jvillemejane/as-spectrum/demo/2024_05_02_Bug_bandeau_led.jpg

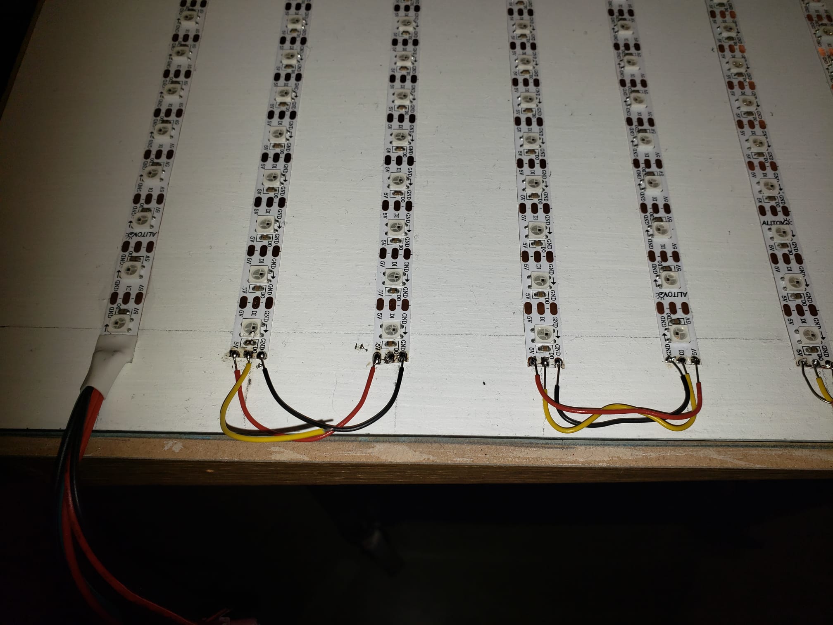
demo/2024_05_02_Bug_bandeau_led.jpg
