jvillemejane/as-spectrum/README.md

# Arts et Sciences Project
2023-2024

This is a test.
