jvillemejane/as-spectrum/Poster_Light_Analyzer.pptx

2023-2024

| INGRID BEVILLARD
| CHRISTOF DIJKSTRA
| MAXENCE DROUIN
| ORIANE KOELLSCH
| APOLLINE GUTH
| MARIE-CAPUCINE POMEAU

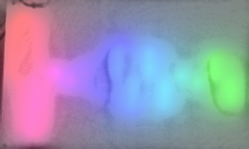
[picture p2: figure]

SPECTRUM

Réalisation d’une œuvre interactive

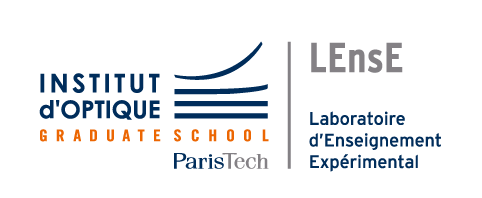
[picture p3: figure]

https://lense.institutoptique.fr/

du son . . .

Onde acoustique

Somme
de notes

Micro

Passe-Bande 1

Passe-Bande 2

Passe-Bande 7

…

Quantification

Traitement
Numérique

Détection niveau

Bande 1

Bande 2

Niveau élevé

Niveau faible

Bande 7

Affichage

Réglage
Intensité

1 note =
1 fréquence

Réglage
Volume

Découpage fréquentiel

Rayonnement électromagnétique

. . . à la lumière

de l’idée . . .

Tableau

Quand l’ingénierie rencontre l’art

Interaction

Son

Lumière

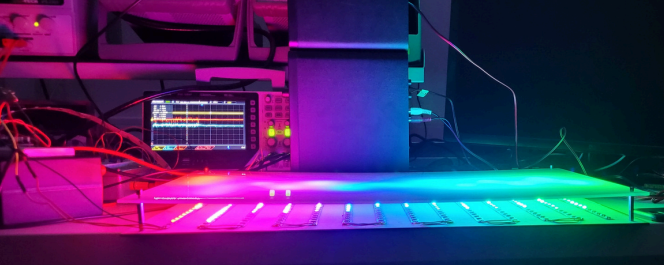
[picture p4: figure]
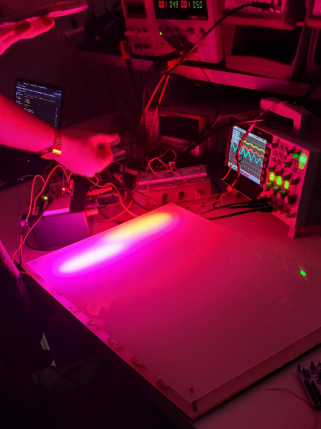
[picture p5: figure]
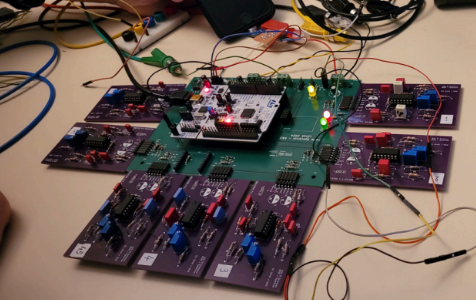
[picture p6: figure]

1 carte mère

3 modes

Analyzer interaction avec le son

Screensaver

Démo

Travail collaboratif

6 étudiant.es

1 artiste

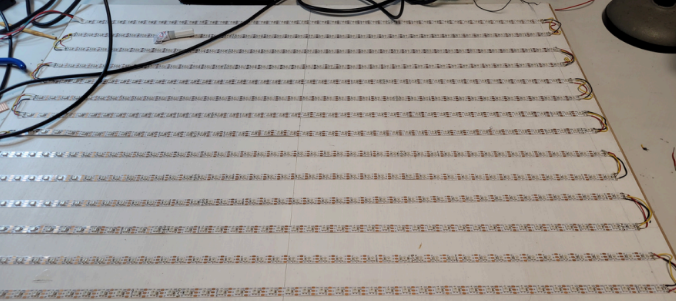
[picture p7: figure]

7 filtres

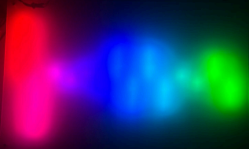
[picture p8: figure]

. . . au prototype

| ERIC MICHEL / Artiste Lumière
| JULIEN VILLEMEJANE

1 laboratoire expérimental

1 ingénieur

630 LEDs

Arts et Sciences

http://artsetsciences.institutoptique.fr/

Un projet

Encadré par
