jvillemejane/as-spectrum/elec_boards/BUG_A_CORRIGER.txt

AS-Spectrum / 'Arts et Sciences' Project / 2024
===============================================

Bugs on electronic board
************************

Bugs on embedde program
***********************
- InterruptIn on PB_12 and PA_12 impossible together ! Delete misc input :/ or no interrupt.
