jvillemejane/as-spectrum/Poster_Light_Analyzer.pdf

du son . . .

## Réalisation d’une œuvre interactive

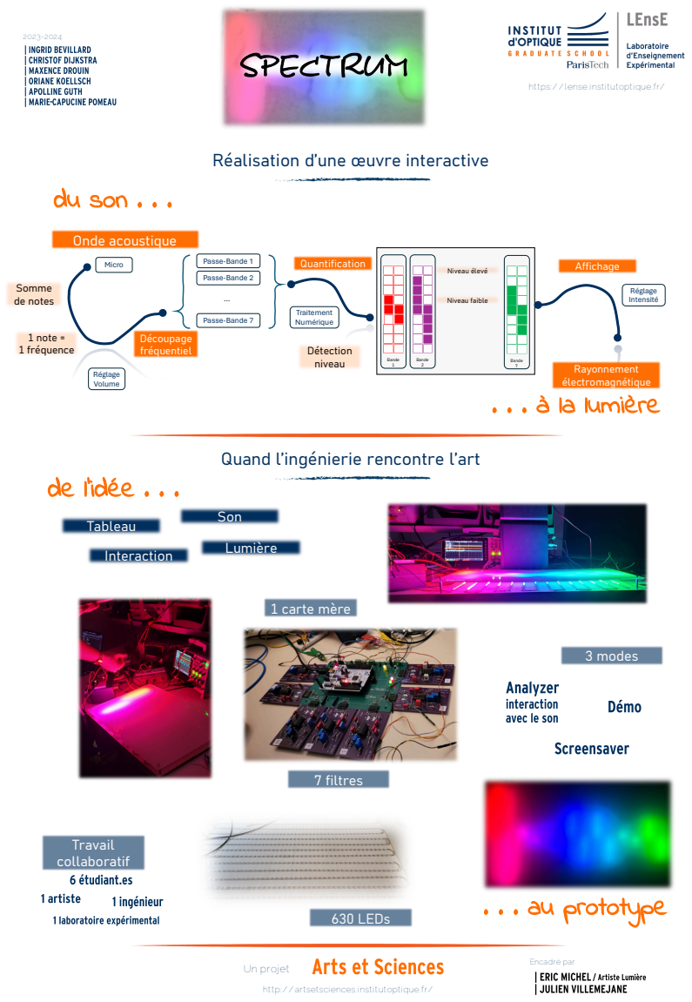
[picture p27: page 1]
Un projet; de l’idée . . .; . . . au prototype; Encadré par; Onde acoustique; Somme de notes; Bande 1; Bande 2; Passe-Bande 1; Passe-Bande 2; Passe-Bande 7; Micro; 1 note = 1 fréquence; Découpage fréquentiel; Quantification; Détection niveau; Traitement Numérique; Niveau faible; Bande 7; Niveau élevé; Affichage; Réglage Volume; Réglage Intensité; Rayonnement électromagnétique . . . à la lumière; SPECTRUM; Tableau; Interaction; Son; Lumière; 630 LEDs; 7 filtres; 3 modes; Travail collaboratif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

https://lense.institutoptique.fr/

Quand l’ingénierie rencontre l’art

http://artsetsciences.institutoptique.fr/
