jvillemejane/as-spectrum/elec_boards/main_board/spectrum_main_pcb.pdf

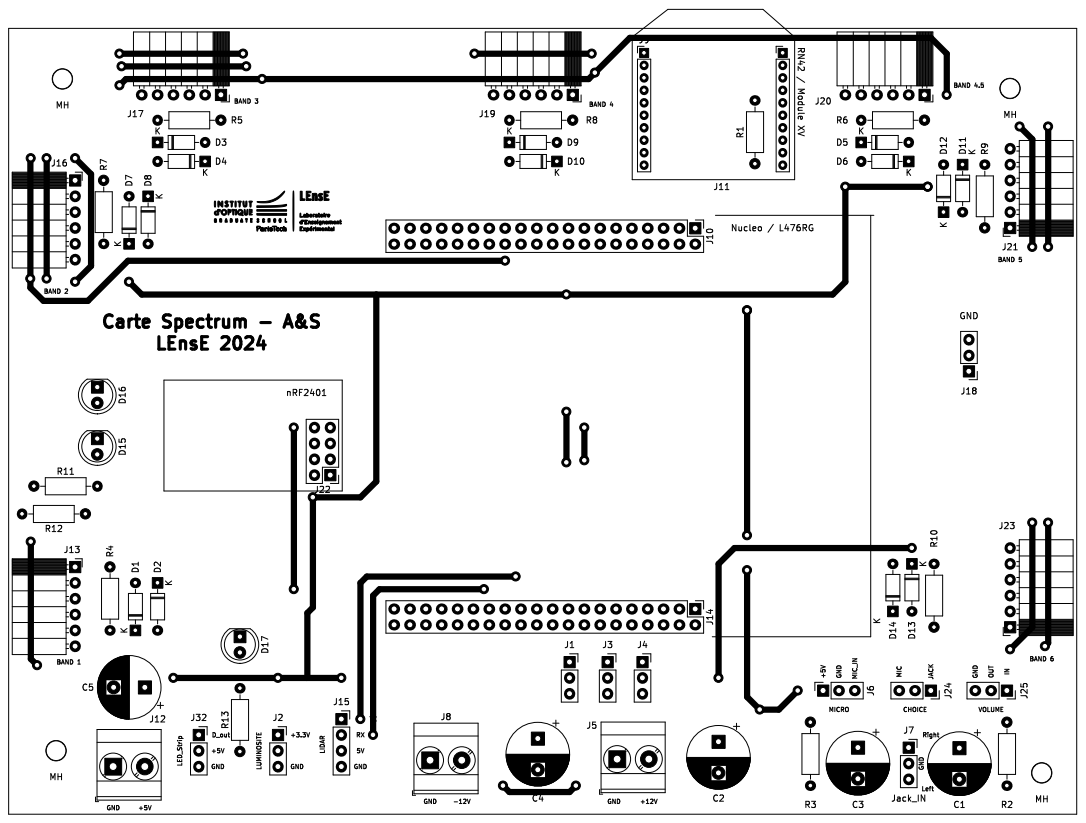
[picture p28: page 1]
