jvillemejane/as-spectrum/elec_boards/main_board/spectrum_main_schematic.pdf

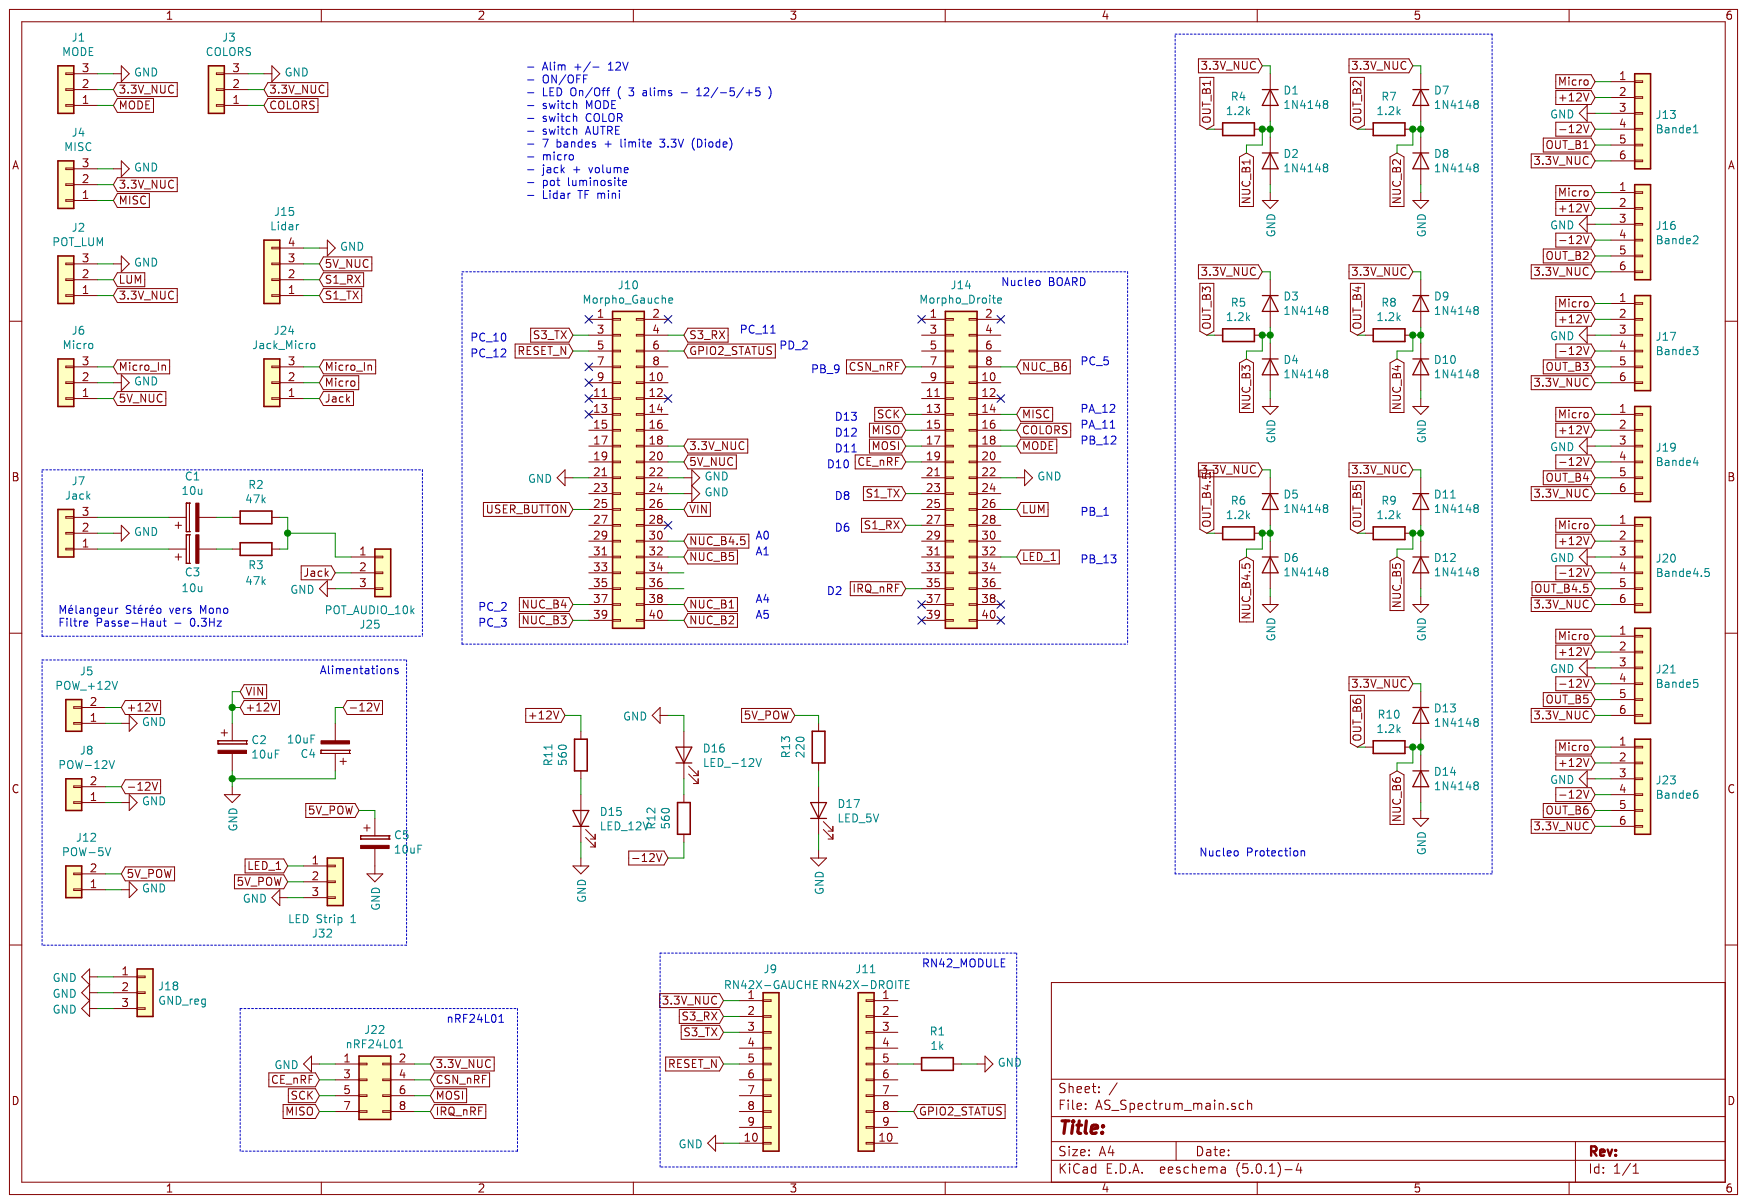
[picture p29: page 1]
