jvillemejane/as-spectrum/elec_boards/filters/spectrum_filter_pcb.pdf

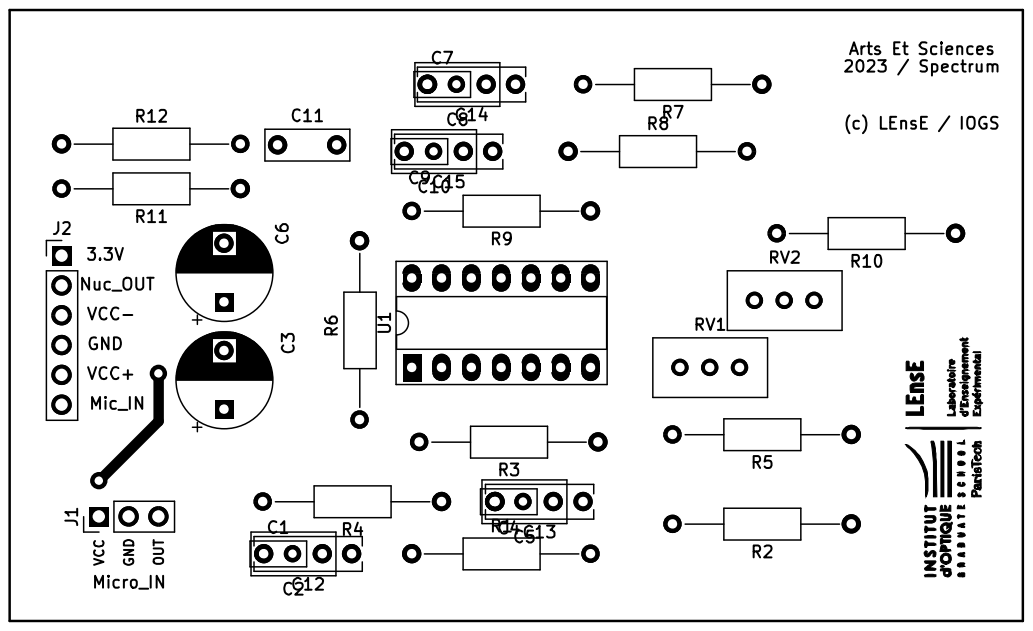
[picture p30: page 1]
