jvillemejane/as-spectrum/elec_boards/filters/spectrum_filter_schematic.pdf

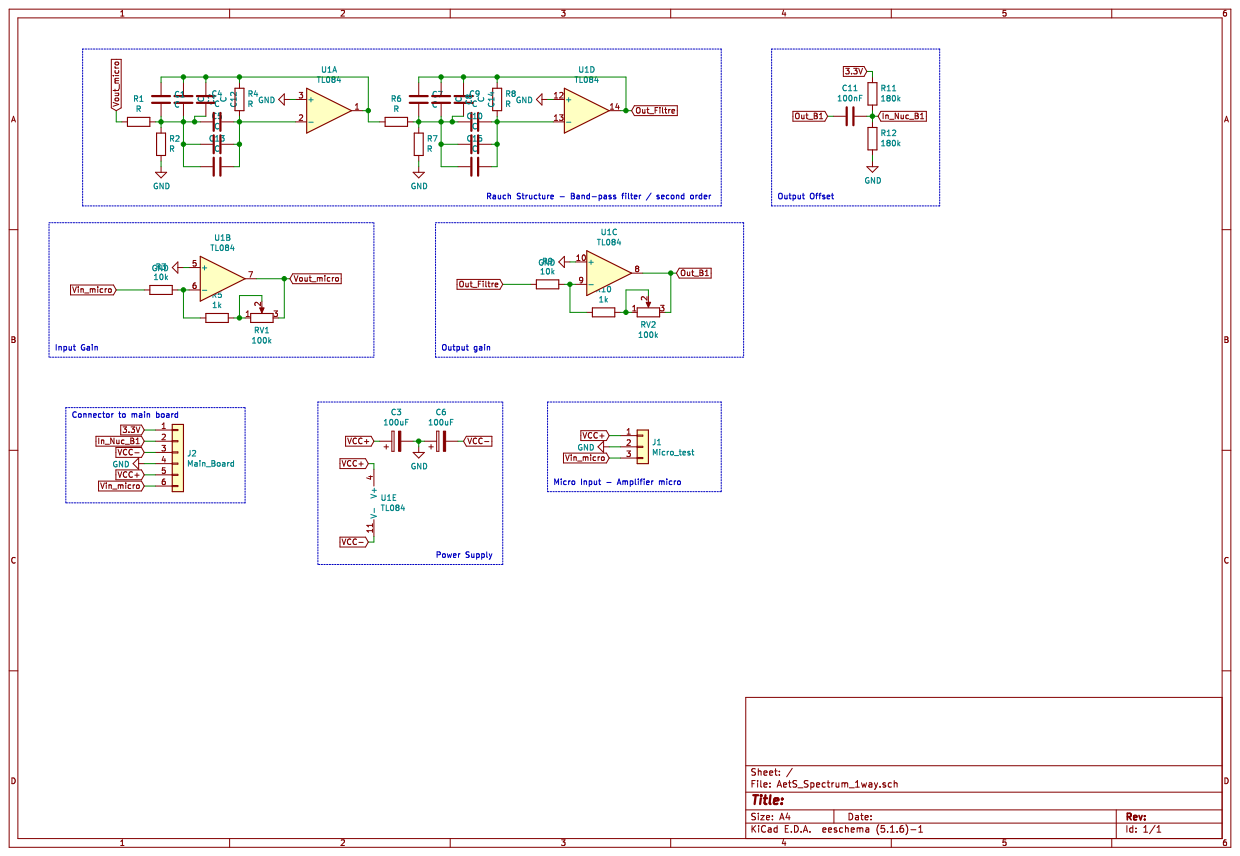
[picture p31: page 1]
