jvillemejane/as-spectrum/elec_boards/main_board/AS_Spectrum_main.kicad_pcb

## KiCad design elec_boards/main_board/AS_Spectrum_main.kicad_pcb (2024-02-15)

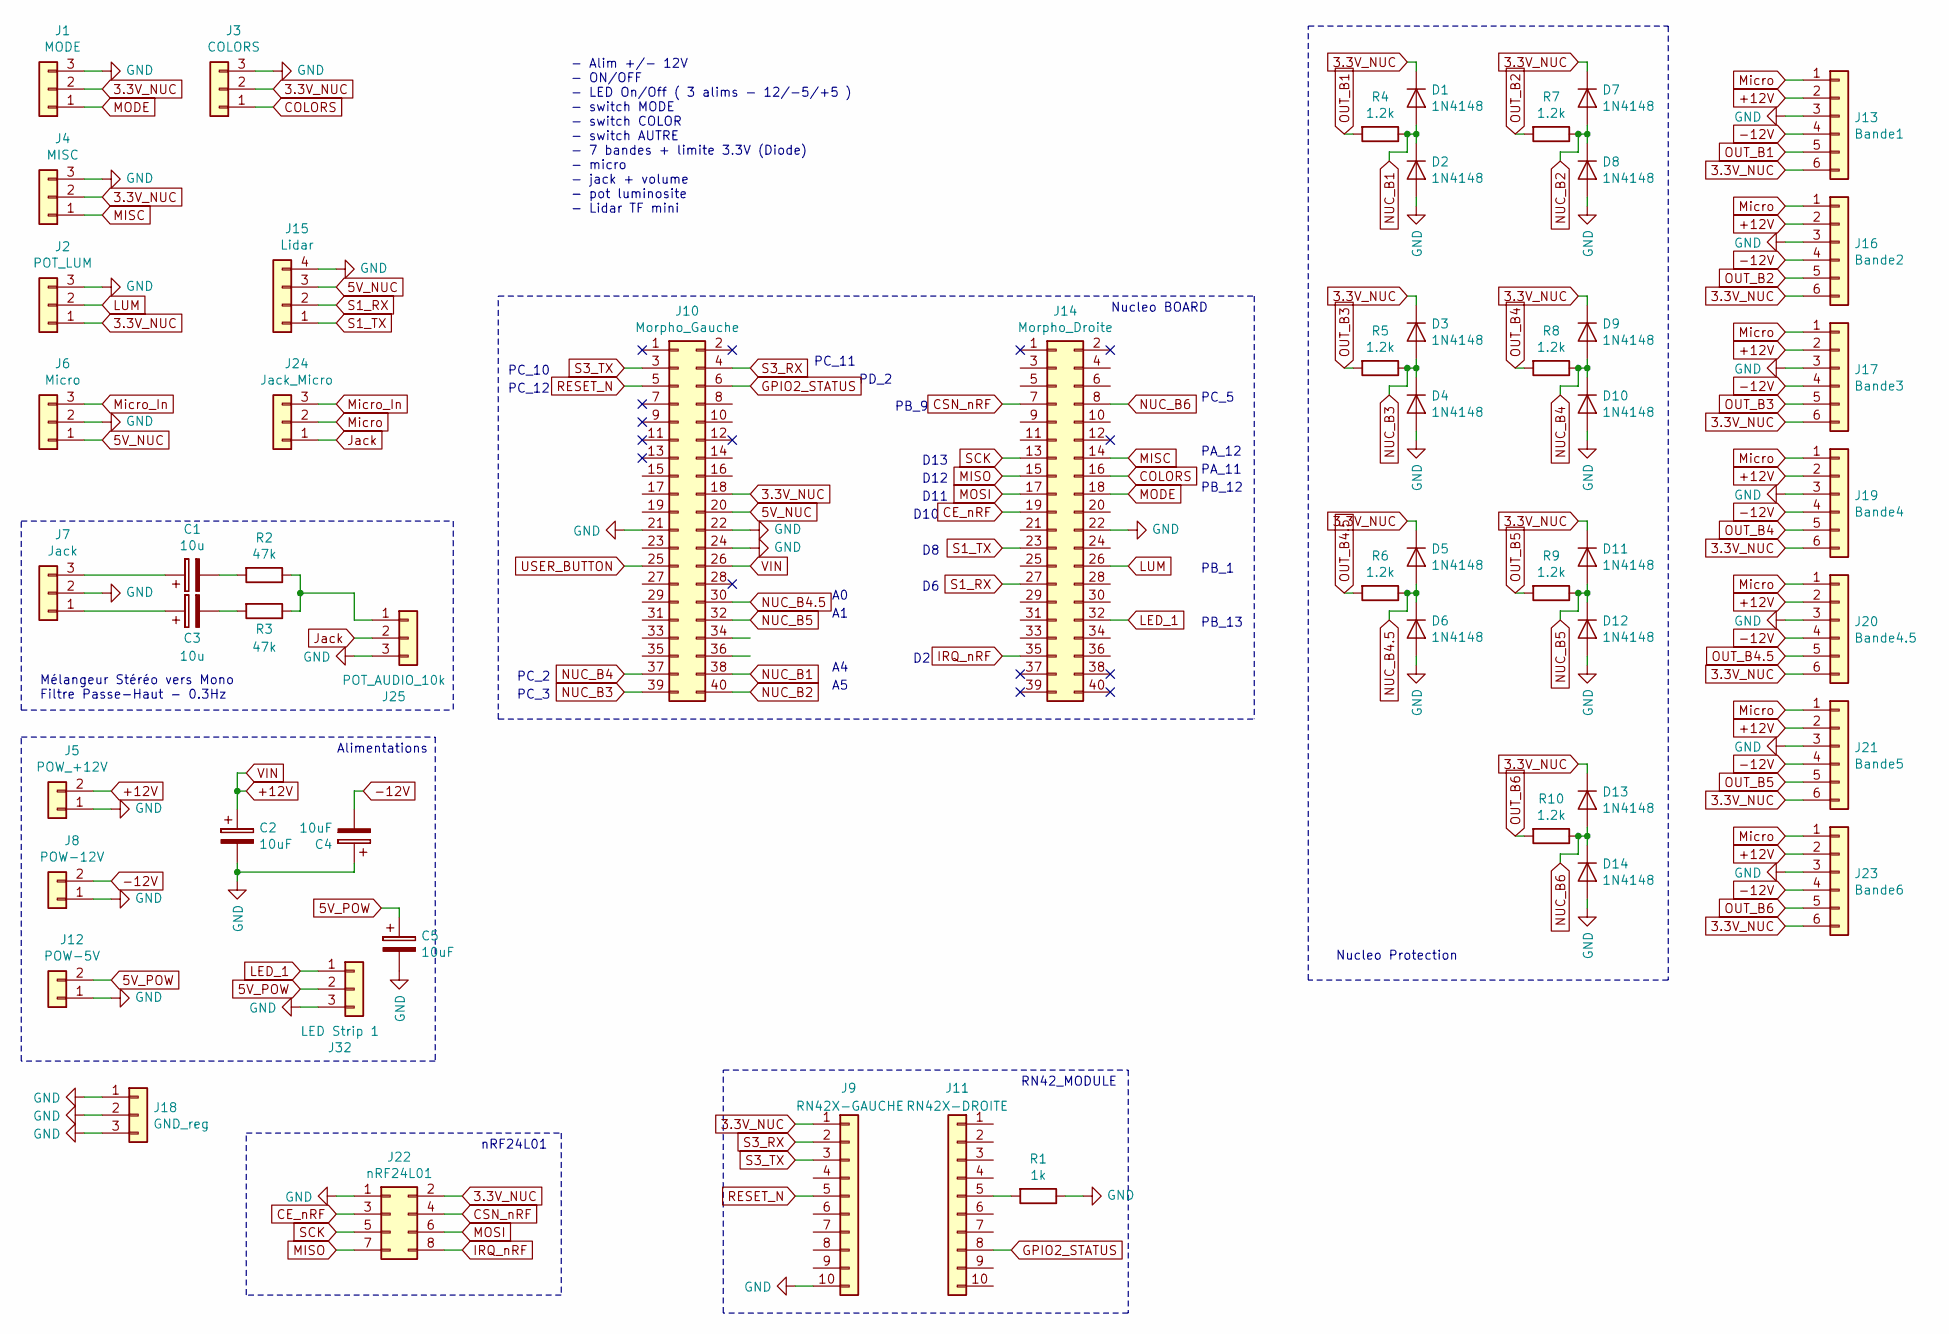
[picture p32: schematic AS_Spectrum_main.sch]

Parts:
C1, C3: 10u; CP_Radial_D10.0mm_P5.00mm
C2, C4, C5: 10uF; CP_Radial_D10.0mm_P5.00mm
D1, D2, D3, D4, D5, D6, D7, D8, D9, D10, D11, D12, D13, D14: 1N4148; D_DO-35_SOD27_P7.62mm_Horizontal
J1: MODE; PinSocket_1x03_P2.54mm_Vertical
J2: POT_LUM; PinSocket_1x03_P2.54mm_Vertical
J3: COLORS; PinSocket_1x03_P2.54mm_Vertical
J4: MISC; PinSocket_1x03_P2.54mm_Vertical
J5: POW_+12V; TerminalBlock_Phoenix_MKDS-3-2-5.08_1x02_P5.08mm_Horizontal
J6: Micro; PinSocket_1x03_P2.54mm_Vertical
J7: Jack; PinSocket_1x03_P2.54mm_Vertical
J8: POW-12V; TerminalBlock_Phoenix_MKDS-3-2-5.08_1x02_P5.08mm_Horizontal
J9: RN42X-GAUCHE; PinHeader_1x10_P2.00mm_Vertical
J10: Morpho_Gauche; PinHeader_2x20_P2.54mm_Vertical
J11: RN42X-DROITE; PinHeader_1x10_P2.00mm_Vertical
J12: POW-5V; TerminalBlock_Phoenix_MKDS-3-2-5.08_1x02_P5.08mm_Horizontal
J13: Bande1; PinSocket_1x06_P2.54mm_Horizontal
J14: Morpho_Droite; PinHeader_2x20_P2.54mm_Vertical
J15: Lidar; PinSocket_1x04_P2.54mm_Vertical
J16: Bande2; PinSocket_1x06_P2.54mm_Horizontal
J17: Bande3; PinSocket_1x06_P2.54mm_Horizontal
J18: GND_reg; PinHeader_1x03_P2.54mm_Vertical
J19: Bande4; PinSocket_1x06_P2.54mm_Horizontal
J20: Bande4.5; PinSocket_1x06_P2.54mm_Horizontal
J21: Bande5; PinSocket_1x06_P2.54mm_Horizontal
J22: nRF24L01; PinHeader_2x04_P2.54mm_Vertical
J23: Bande6; PinSocket_1x06_P2.54mm_Horizontal
J24: Jack_Micro; PinSocket_1x03_P2.54mm_Vertical
J25: POT_AUDIO_10k; PinSocket_1x03_P2.54mm_Vertical
J32: LED Strip 1; PinSocket_1x03_P2.54mm_Vertical
R1: 1k; R_Axial_DIN0207_L6.3mm_D2.5mm_P10.16mm_Horizontal
R2, R3: 47k; R_Axial_DIN0207_L6.3mm_D2.5mm_P10.16mm_Horizontal
R4, R5, R6, R7, R8, R9, R10: 1.2k; R_Axial_DIN0207_L6.3mm_D2.5mm_P10.16mm_Horizontal

Connections:
3.3V_NUC: D1.1 (K), D3.1 (K), D5.1 (K), D7.1 (K), D9.1 (K), D11.1 (K), D13.1 (K), J1.2, J2.1, J3.2, J4.2, J9.1, J10.18, J13.6, J16.6, J17.6, J19.6, J20.6, J21.6, J22.2, J23.6
5V_NUC: J6.1, J10.20, J15.3
5V_POW: C5.1, J12.2, J32.2; also elsewhere on the board
+12V: C2.1, J5.2, J10.26, J13.2, J16.2, J17.2, J19.2, J20.2, J21.2, J23.2; also elsewhere on the board
-12V: C4.2, J8.2, J13.4, J16.4, J17.4, J19.4, J20.4, J21.4, J23.4; also elsewhere on the board
CE_nRF: J14.19, J22.3
COLORS: J3.1, J14.16
CSN_nRF: J14.7, J22.4
GND: C2.2, C4.1, C5.2, D2.2 (A), D4.2 (A), D6.2 (A), D8.2 (A), D10.2 (A), D12.2 (A), D14.2 (A), J1.3, J2.3, J3.3, J4.3, J5.1, J6.2, J7.2, J8.1, J9.10, J10.21, J10.22, J10.24, J12.1, J13.3, J14.22, J15.4, J16.3, J17.3, J18.1, J18.2, J18.3, J19.3, J20.3, J21.3, J22.1, J23.3, J25.3, J32.3, R1.1; also elsewhere on the board
GPIO2_STATUS: J10.6, J11.8
IRQ_nRF: J14.35, J22.8
Jack: J24.1, J25.2
LED_1: J14.32, J32.1
LUM: J2.2, J14.26
MISC: J4.1, J14.14
MISO: J14.15, J22.7
MODE: J1.1, J14.18
MOSI: J14.17, J22.6
Micro: J13.1, J16.1, J17.1, J19.1, J20.1, J21.1, J23.1, J24.2
Micro_In: J6.3, J24.3
NUC_B1: D1.2 (A), D2.1 (K), J10.38, R4.1
NUC_B2: D7.2 (A), D8.1 (K), J10.40, R7.1
NUC_B3: D3.2 (A), D4.1 (K), J10.39, R5.1
NUC_B4: D9.2 (A), D10.1 (K), J10.37, R8.1
NUC_B4.5: D5.2 (A), D6.1 (K), J10.30, R6.1
NUC_B5: D11.2 (A), D12.1 (K), J10.32, R9.1
NUC_B6: D13.2 (A), D14.1 (K), J14.8, R10.1
unnamed: C1.1, J7.3
unnamed: C1.2, R2.2
unnamed: C3.1, J7.1
unnamed: C3.2, R3.2
unnamed: J11.5, R1.2
unnamed: J25.1, R2.1, R3.1
OUT_B1: J13.5, R4.2
OUT_B2: J16.5, R7.2
OUT_B3: J17.5, R5.2
OUT_B4: J19.5, R8.2
OUT_B4.5: J20.5, R6.2
OUT_B5: J21.5, R9.2
OUT_B6: J23.5, R10.2
RESET_N: J9.5, J10.5
S1_RX: J14.27, J15.2
S1_TX: J14.23, J15.1
S3_RX: J9.2, J10.4
S3_TX: J9.3, J10.3
SCK: J14.13, J22.5
USER_BUTTON: J10.25

Notes on the sheet:
RN42_MODULE
Nucleo BOARD
- Alim +/- 12V - ON/OFF - LED On/Off ( 3 alims - 12/-5/+5 ) - switch MODE - switch COLOR - switch AUTRE - 7 bandes + limite 3.3V (Diode) - micro - jack + volume - pot luminosite - Lidar TF mini
Mélangeur Stéréo vers Mono Filtre Passe-Haut - 0.3Hz
Alimentations
nRF24L01
Nucleo Protection
PC_5
PC_3
PC_2
PA_12
PA_11
PB_12
D13
D12
D11
PC_10
PC_12
PC_11
PD_2
PB_13
PB_1
PB_9
D10

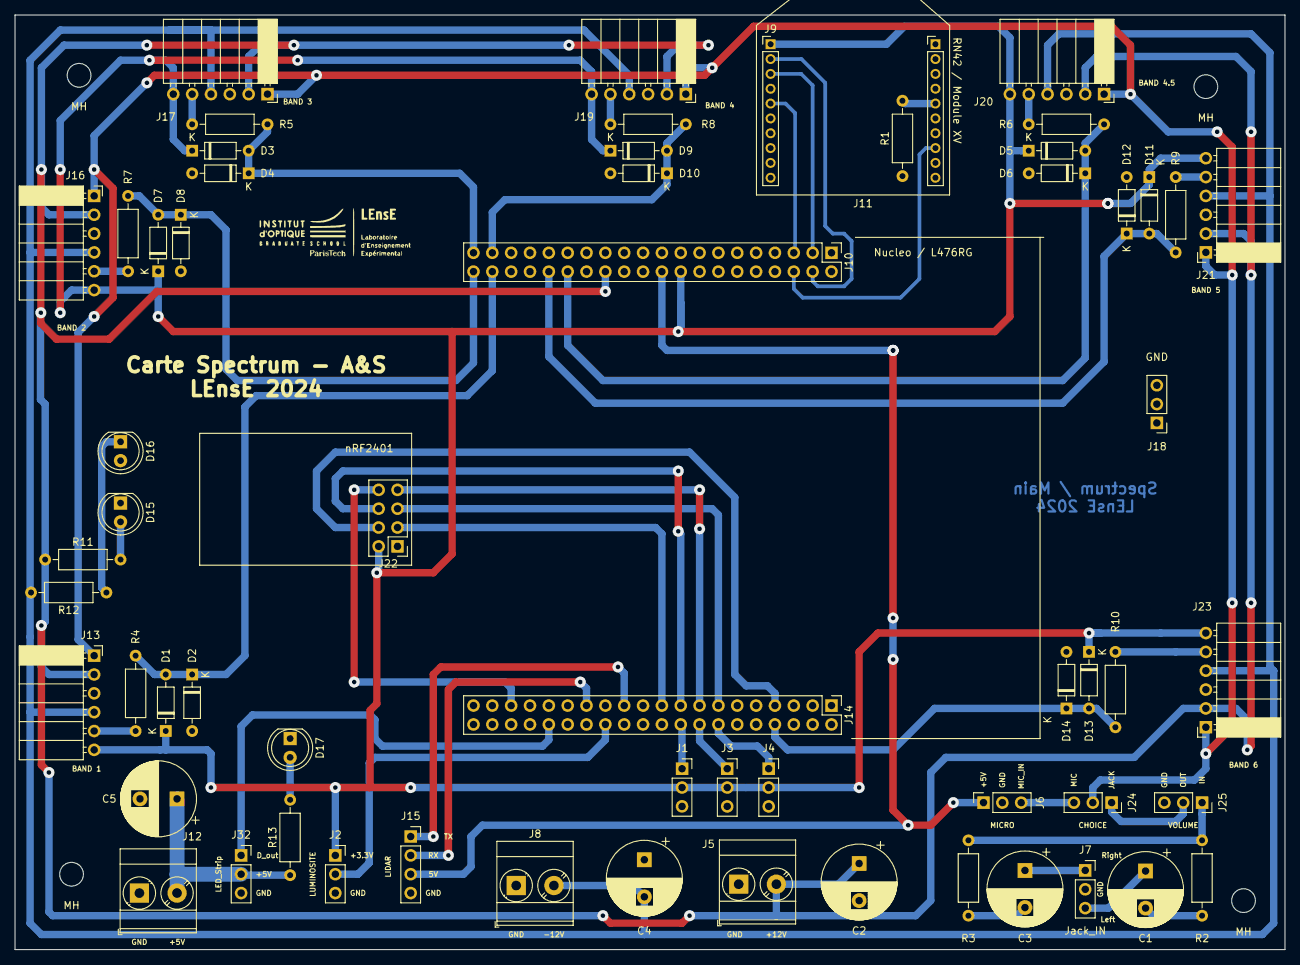
[picture p33: board AS_Spectrum_main.kicad_pcb from above]

Board: 2 copper layers, 171.2 x 126.0 mm, 65 parts (0 on the bottom side), 49 nets.

Other parts of the board:
D15: LED_12V; LED_D5.0mm_FlatTop
D16: LED_-12V; LED_D5.0mm_FlatTop
D17: LED_5V; LED_D5.0mm_FlatTop
MH: MountingHole_3.2mm_M3
MH#2, MH#3, MH#4: MountingHole_3.2mm_M3
R11, R12: 560; R_Axial_DIN0207_L6.3mm_D2.5mm_P10.16mm_Horizontal
R13: 220; R_Axial_DIN0207_L6.3mm_D2.5mm_P10.16mm_Horizontal

Their connections:
5V_POW: R13.1; also elsewhere on the board
+12V: R11.1; also elsewhere on the board
-12V: R12.2; also elsewhere on the board
GND: D15.1, D16.2, D17.1; also elsewhere on the board
unnamed: D15.2, R11.2
unnamed: D16.1, R12.1
unnamed: D17.2, R13.2
