jvillemejane/as-spectrum/elec_boards/filters/AetS_Spectrum_1way.kicad_pcb

## KiCad design elec_boards/filters/AetS_Spectrum_1way.kicad_pcb (2024-02-15)

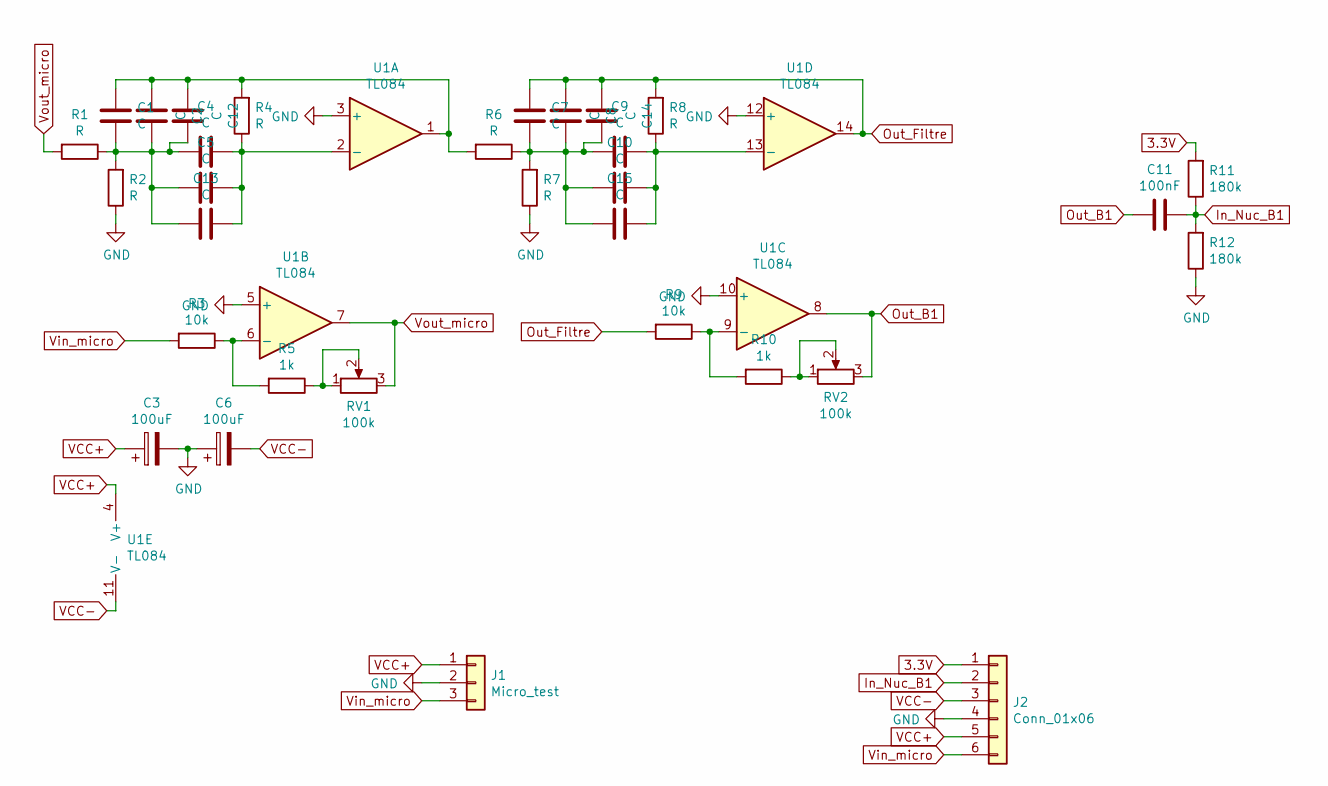
[picture p34: schematic AetS_Spectrum_1way.sch]

Parts:
C1, C4, C7, C9: C; C_Rect_L4.6mm_W2.0mm_P2.50mm_MKS02_FKP02
C2, C5, C8, C10: C; C_Rect_L7.0mm_W3.5mm_P5.00mm
C3, C6: 100uF; CP_Radial_D8.0mm_P5.00mm
C11: 100nF; C_Rect_L7.0mm_W2.5mm_P5.00mm
C12, C13, C14, C15: C; C_Rect_L9.0mm_W2.7mm_P7.50mm_MKT
J1: Micro_test; PinHeader_1x03_P2.54mm_Vertical
J2: Conn_01x06; PinHeader_1x06_P2.54mm_Vertical
R1, R2, R4, R6, R7, R8: R; R_Axial_DIN0207_L6.3mm_D2.5mm_P15.24mm_Horizontal
R3, R9: 10k; R_Axial_DIN0207_L6.3mm_D2.5mm_P15.24mm_Horizontal
R5, R10: 1k; R_Axial_DIN0207_L6.3mm_D2.5mm_P15.24mm_Horizontal
R11, R12: 180k; R_Axial_DIN0207_L6.3mm_D2.5mm_P15.24mm_Horizontal
RV1, RV2: 100k; Potentiometer_Bourns_3296W_Vertical
U1: TL084; DIP-14_W7.62mm_Socket_LongPads

Connections:
3.3V: J2.1, R11.2
GND: C3.2, C6.1, J1.2, J2.4, R2.1, R7.1, R12.1, U1.3 (+), U1.5 (+), U1.10 (+), U1.12 (+)
In_Nuc_B1: C11.1, J2.2, R11.1, R12.2
unnamed: C1.1, C2.2, C12.2, R4.2, R6.2, U1.1
unnamed: C1.2, C2.1, C4.2, C5.2, C12.1, C13.2, R1.1, R2.2
unnamed: C9.1, C10.1, C15.1, R8.1, U1.13 (-)
unnamed: C7.2, C8.1, C9.2, C10.2, C14.1, C15.2, R6.1, R7.2
unnamed: C4.1, C5.1, C13.1, R4.1, U1.2 (-)
unnamed: R3.1, R5.2, U1.6 (-)
unnamed: R5.1, RV1.1, RV1.2
unnamed: R10.1, RV2.1, RV2.2
unnamed: R9.1, R10.2, U1.9 (-)
Out_B1: C11.2, RV2.3, U1.8
Out_Filtre: C7.1, C8.2, C14.2, R8.2, R9.2, U1.14
VCC+: C3.1, J1.1, J2.5, U1.4 (V+)
VCC-: C6.2, J2.3, U1.11 (V-)
Vin_micro: J1.3, J2.6, R3.2
Vout_micro: R1.2, RV1.3, U1.7

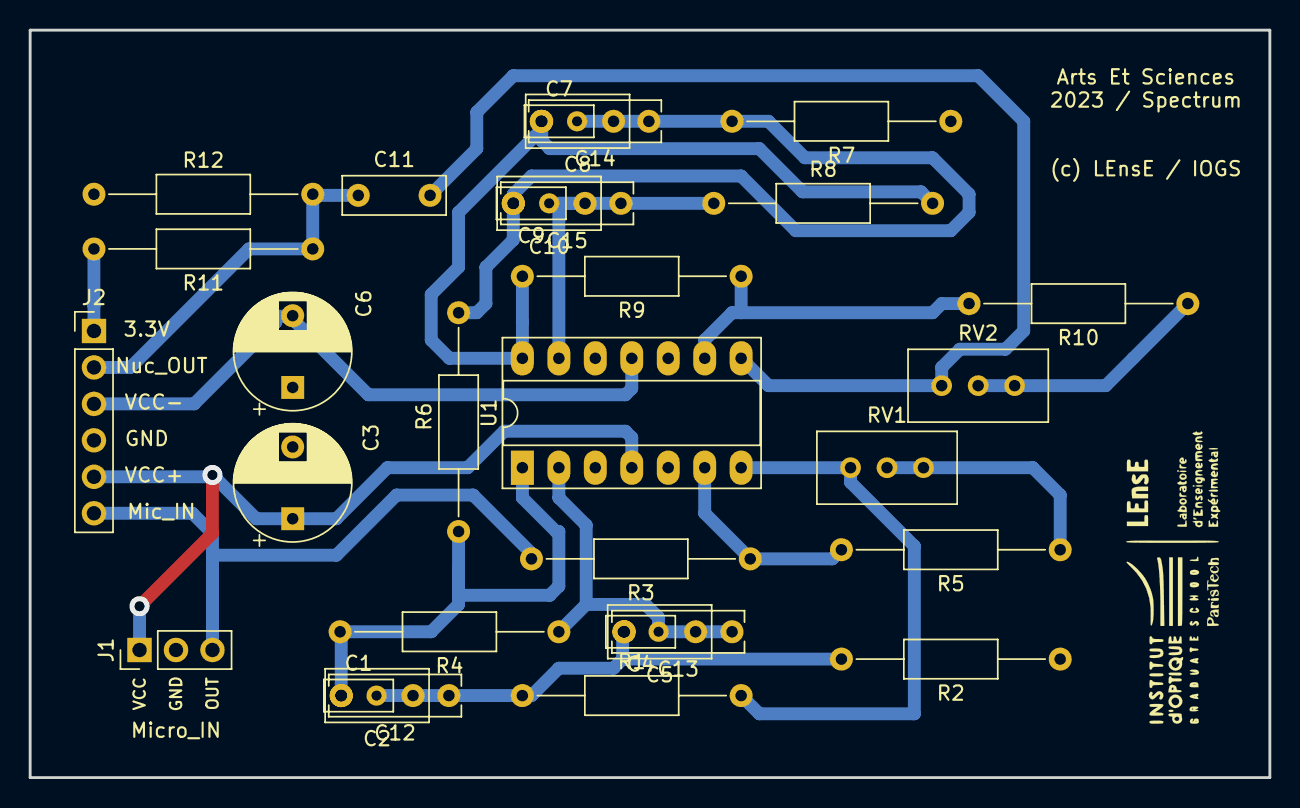
[picture p35: board AetS_Spectrum_1way.kicad_pcb from above]

Board: 2 copper layers, 86.4 x 52.1 mm, 32 parts (0 on the bottom side), 18 nets.
