jvillemejane/as-spectrum/(commit log)

2024-02-14 Update Schematic Main Board
    [AS_Spectrum_main.kicad_pcb, AS_Spectrum_main.sch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]
2024-02-14 Update Main Board Schematic and PCB
    [AS_Spectrum_main-B_Cu.gbr, AS_Spectrum_main-B_Mask.gbr, AS_Spectrum_main-B_Paste.gbr, AS_Spectrum_main-B_SilkS.gbr, AS_Spectrum_main-Edge_Cuts.gbr, AS_Spectrum_main-F_Cu.gbr, AS_Spectrum_main-F_Mask.gbr, AS_Spectrum_main-F_Paste.gbr]
2024-02-15 Update Schematics and PCB
    [AS_Spectrum_main-B_Cu.gbr, AS_Spectrum_main-B_Mask.gbr, AS_Spectrum_main-B_Paste.gbr, AS_Spectrum_main-B_SilkS.gbr, AS_Spectrum_main-Edge_Cuts.gbr, AS_Spectrum_main-F_Cu.gbr, AS_Spectrum_main-F_Mask.gbr, AS_Spectrum_main-F_Paste.gbr]
2024-02-15 Update Schematics and PCB - Adding LEDs
    [AS_Spectrum_main-B.Cu.gbr, AS_Spectrum_main-B.Mask.gbr, AS_Spectrum_main-B.Paste.gbr, AS_Spectrum_main-B.SilkS.gbr, AS_Spectrum_main-Edge.Cuts.gbr, AS_Spectrum_main-F.Cu.gbr, AS_Spectrum_main-F.Mask.gbr, AS_Spectrum_main-F.Paste.gbr]
2024-02-15 Update PCB
2024-05-02 Adding filters characterization and demo test
